wkazubski/gnMAX2769/gnMAX2769.png

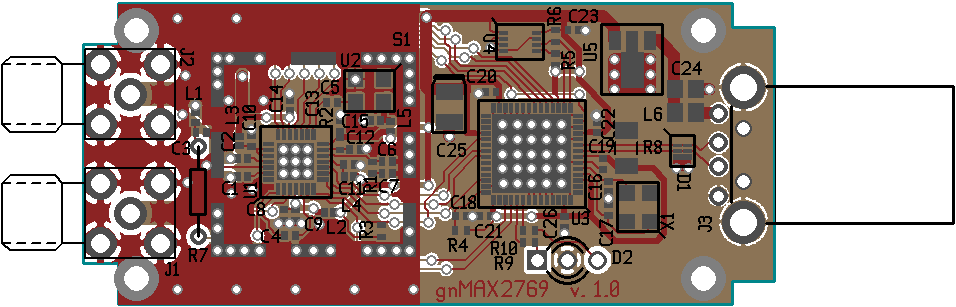
gnMAX2769.png
