wkazubski/gnMAX2769/gnMAX2769-1.pdf

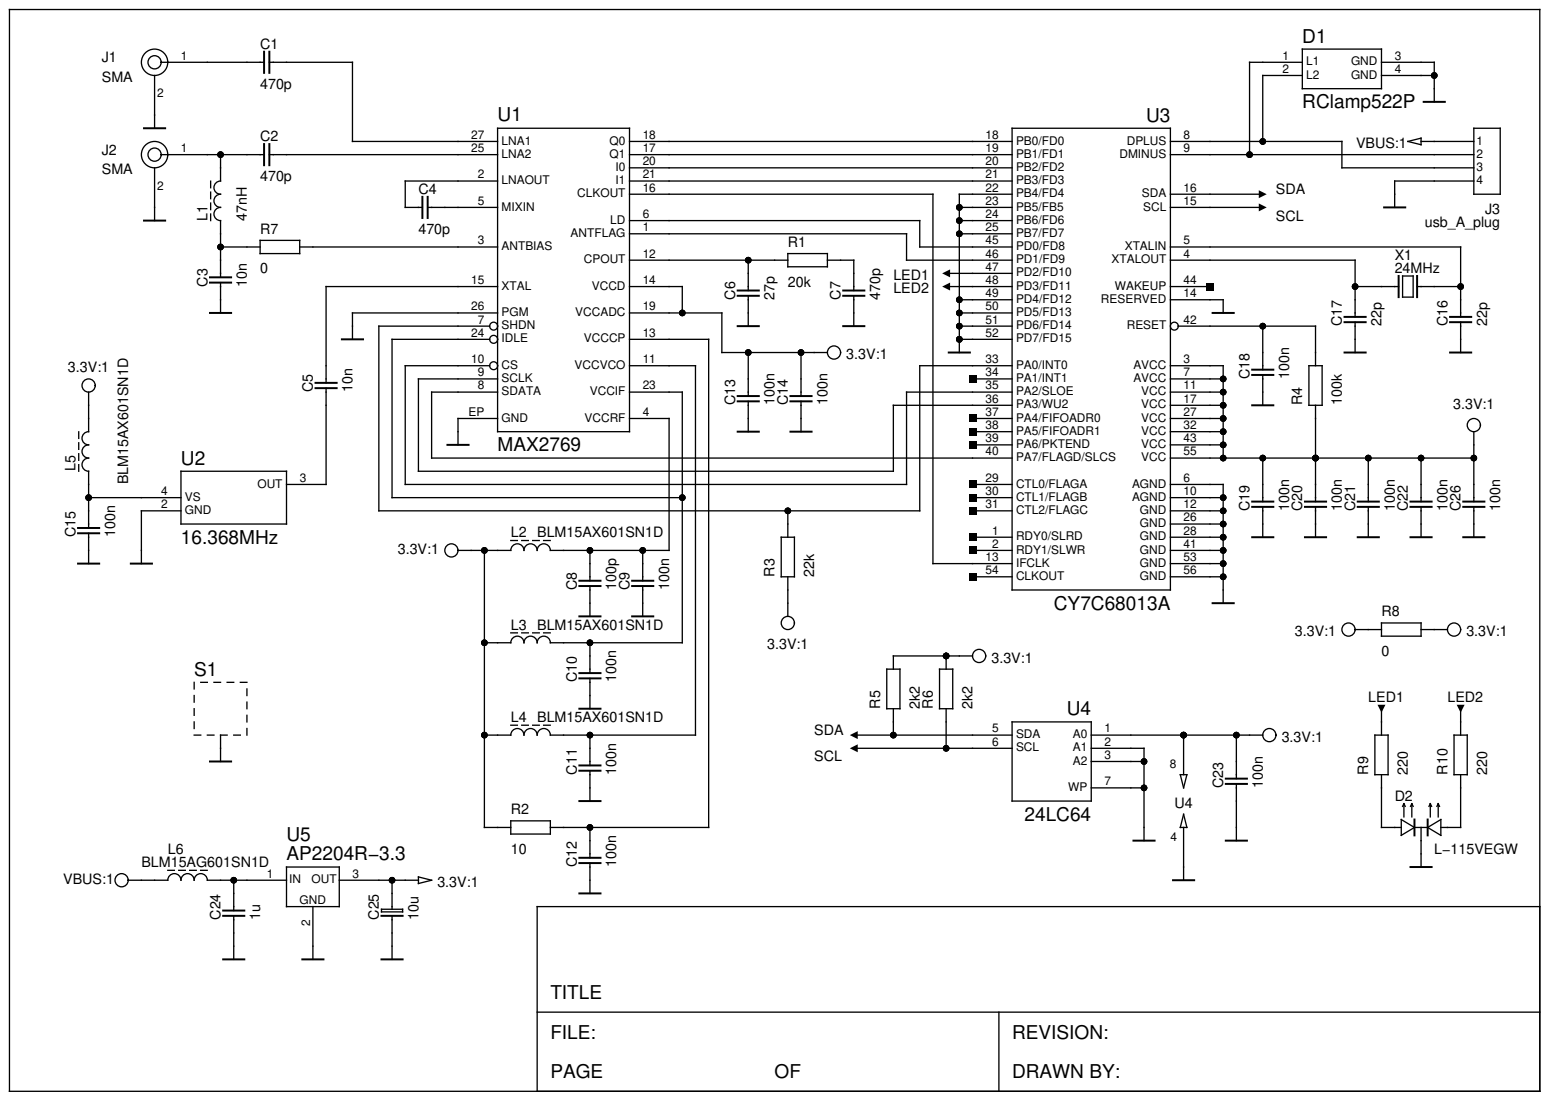
[picture p2: page 1]

17 Q1 | 9 DMINUS
20 I0 | 16 SDA 15 SCL SCL
