wkazubski/gnMAX2769/(list of files, drawings)

Other design files:
board/gnMAX2769.pcb
