wkazubski/gnMAX2769/(commit log)

2019-12-31 Add BOM and more description
2020-01-04 Fixes to BOM
2020-01-16 Fixed SPI write code
    [gnmax_max2769.c]
2020-02-12 Enable on-board LEDs
2020-03-03 Use fast I2C transfer (400kHz)
2022-11-29 Change component values in RF input circuit
    [gnMAX2769-1.sch]
2022-11-29 Fix BOM
